kicode01/voltsense-iot/docs/HANDOFF.md

# VoltSense — hardware handoff & build guide

**Who this is for:** whoever has the physical components. You do not need to have seen the code or  
this project before. Follow it top to bottom.

**What you are building:** an ESP32 that senses whether a room is occupied, switches three mains  
sockets, measures the current each one draws, and reports all of it to a phone app. It alerts when  
the room empties or a port overloads.

**What you need from the code owner** (ask them — do not guess):

| Thing | Why |
| --- | --- |
| The **pairing key** (64 hex characters) | Baked into the firmware at build time so the device can register itself. **Sent privately — never put it in a repo or a shared doc.** |
| Confirmation the app is deployed | The device talks to `https://voltsense-iot.vercel.app` |
| A phone with the app installed and signed in | To claim the device at the end |

---

## ⚠️ READ THIS BEFORE TOUCHING ANYTHING

**This device switches mains.** 230 V at up to 5 A per port is lethal and will destroy equipment.

- **Never wire or rewire with the mains connected.** Isolate at the breaker, then verify it is dead.
- **Do the whole bring-up with low-voltage loads first** — 12 V lamps, a phone charger. Only move to  
  mains once Stages 1–4 below pass.
- If you are not confident with mains wiring, stop and get someone who is. Nothing here is worth a  
  shock.
- **Fit the fuses.** One per port, in the live conductor, upstream of the relay — specs in §1.1.  
  The software's overcurrent cutoff is a convenience, not protection: the sensor saturates at 5 A  
  and a welded relay contact cannot be opened in code. Do not energise mains without them.

---

## 1. What's in the box

| Part | Notes |
| --- | --- |
| ESP32 dev board | 4 MB flash minimum |
| HC-SR501 PIR motion sensor | Occupancy. **Needs 5 V.** |
| 3-channel relay module | Switches the three sockets |
| 3× ACS712 current sensor | One per socket. **5 A variant** (the 20 A and 30 A parts look identical and silently break every reading) |
| **Fuse — one per port** | See §1.1. Not optional. |
| 5 V regulated supply | Enough for the ESP32 + relay coils + sensors |

### 1.1 The fuses — fit them, and fit the right ones

The software has an overcurrent cutoff, but it is **explicitly not a fuse**, and the firmware says so  
in its own source. Two things it physically cannot do:

- **The ACS712 saturates at 5 A.** A dead short drawing 30 A reads as ~5 A. The fault is *invisible*  
  to the software — it can only see the band just below the ceiling.
- **A welded relay contact cannot be opened in code.** Opening the relay is best-effort.

So the software and the fuse cover different failures, deliberately:

```
4.5 A   software cutoff (debounced ~0.5 s)  -> soft/sustained overloads; opens the relay
5.0 A   fuse                                -> hard faults, and anything above what
                                               the saturated sensor can see
```

The software threshold sits just **below** the fuse so it acts first on the recoverable case, and the  
fuse is the backstop for what software cannot reach.

**Specification — check what you have against this:**

| Property | Requirement | Why |
| --- | --- | --- |
| Property | Requirement | Why |
|---|---|---|
| **Rating** | **Sized to the weakest link**, not the sensor. For typical parts — 1.5 mm² (~16 AWG) wire and a 10 A relay module — **5 A** is a sensible, conservative choice. **3 A** is *better* protection if the loads are known small | A fuse protects the **wiring and the relay**. A meter that can read 100 A does **not** justify a 100 A fuse |
| **Voltage** | **250 VAC minimum** | It is switching mains |
| **Type** | **Time-lag / slow-blow (T)**, not fast-blow (F) | Motors and switch-mode supplies draw large inrush; a fast fuse nuisance-trips on a healthy appliance. The firmware debounces overcurrent for exactly the same reason |
| **Construction** | **Ceramic / sand-filled — NOT glass** | At 230 V a glass fuse can arc internally and shatter. Ceramic quenches the arc |
| **Breaking capacity** | Must exceed the prospective short-circuit current at the socket | A fuse that cannot interrupt the fault is decoration |
| **Placement** | In the **live** conductor, **one per port**, **upstream of the relay** | So it protects the relay contacts as well as the wiring |
| **Wire gauge** | Must carry the fuse rating continuously (≈0.75 mm² for 5 A, ≈1.5 mm² for 10 A) | A fuse protects the **wiring** — the wire must not be the weakest link |
| **Size** | 5 × 20 mm is the common size; 6.3 × 32 mm has higher breaking capacity | Either is fine domestically |

So a normal specification reads something like **`T5A 250V 5×20mm ceramic`** — time-lag, 5 amp, 250 VAC, ceramic cartridge.

**The rule that decides the rating:**

> A fuse protects the **WIRING and the relay** — not the sensor, and not the load.

```
fuse rating  <=  min( wire current rating , relay contact rating )
```

**A second, independent reason to stay near 5 A on the shipped firmware:** the ACS712-05B current sensors saturate at 5 A, so the software overcurrent cutoff (default 4.5 A) cannot see a fault above that. Keeping the fuse just above the software threshold preserves the layering. **If the build uses a PZEM-004T instead of ACS712s, that constraint disappears** and the rating is set purely by the wiring and relay — see §1.2.

If what your group has is a different rating or type, **say so before wiring** rather than fitting it  
and hoping. A 10 A glass fuse is not equivalent to a 5 A ceramic time-lag one.

#### Reading the marking — the letter that actually matters

A 5×20 mm fuse carries its whole specification in a short code. Look for **`T5AH250V`**:

| Character | Means | Why it matters here |
|---|---|---|
| **T** | Time-lag (slow-blow). `F` = fast | Tolerates motor/SMPS inrush. `F` nuisance-trips on a healthy appliance |
| **5A** | Rating | See the rating rule above |
| **H** | **High** breaking capacity. `L` = low | **This is the one people miss.** Per IEC 60127-2 a 5×20 mm fuse must interrupt **1500 A** to earn `H`; an `L` part is only tested to **35 A**. At 230 V an `L` fuse can fail to clear the fault, arc, and shatter |
| **250V** | Voltage rating | It is switching mains |

So `T5A 250V ceramic` is *almost* the spec — add the **H**. If the marking only says `T5A 250V` with no
`H`, treat it as `L` and prefer a part that states `H` explicitly.

**Also buy a holder:** a **5×20 mm panel-mount or inline fuse holder rated 250 VAC**. Fuses are
single-use; a holder means replacing a fuse rather than resoldering, and a soldered-in fuse turns the
joint into a hot spot. The holder needs its own voltage rating, not just a current one.

#### Do not use these — each is a common, real mistake

| Don't | Why |
|---|---|
| **Glass fuse** | Almost always `L`. Can arc internally and shatter at 230 V |
| **Automotive blade fuse** | Rated **~32 V DC**. Wrong voltage class — it will not safely interrupt a mains fault, whatever its current rating says |
| **Fast-blow (`F`)** | Nuisance-trips on inrush; healthy loads look like faults |
| **Anything well above the rating** | On the shipped ACS712 firmware it leaves the blind band the saturated sensor cannot see |
| **A fuse with no holder** | No safe replacement, and the solder joint becomes a hot spot |

#### Alternative: a small MCB instead of fuses

A **6 A Type-C miniature circuit breaker** is a legitimate substitute, and arguably nicer for a
project: it is **resettable**, so a trip costs a click rather than a fuse, and you carry no spares.
Type C tolerates inrush better than Type B.

Two things to keep straight if you go this way:

- Between the sensor's 5 A ceiling and the 6 A breaker nothing trips promptly — but software is blind
  above 5 A anyway, so nothing is lost that was ever there. The breaker still protects the **wiring**
  against a sustained overload, which is its actual job.
- **The wiring must then be rated for the breaker, not the old fuse.** A breaker protects the wire, so
  the wire must not be the weakest link.

Optional, only if the code owner says so: an AC voltage sensor (ZMPT101B) for real-power metering.  
**Do not fit it unless asked** — it needs calibration and can damage the ESP32 if wired wrong. See  
`docs/VOLTAGE-SENSING.md`.

---

### 1.2 This build is ACS712 + ZMPT101B — do not substitute

The architecture is fixed and the firmware is written around it:

| Part | Role | Quantity |
|---|---|---|
| **ACS712** (5 A variant) | Current sensing, one per port, on the ESP32's ADC1 pins | **3** |
| **ZMPT101B** | Voltage sensing, on GPIO 33 — optional, enables real power (W) instead of VA | **1** |

**Do not swap either part, and do not add a combined energy-meter module.** The firmware reads three
analogue current channels and one analogue voltage channel; anything else is a new integration, not a
drop-in replacement.

In particular: **do not connect a UART energy-meter module (e.g. a PZEM-004T) to GPIO 33.** That pin
is an analogue input — a serial device wired to it will not work and may be damaged.

Alternatives that were considered, and why they were not chosen, are recorded in
`docs/VOLTAGE-SENSING.md` §7. That is design history for the report, **not** wiring instructions.

## 2. Wiring

### Pins — these are fixed by the firmware

| Function | ESP32 pin | Goes to |
| --- | --- | --- |
| Relay 1 / 2 / 3 | **23, 21, 19** | Relay module IN1 / IN2 / IN3 |
| Current sensor 1 / 2 / 3  | **34, 35, 32** | ACS712 OUT, one per port |
| PIR | **22** | HC-SR501 OUT |
| Relay module VCC | 5 V | 5 V rail |
| Relay module GND | GND | **Common ground** |
| mmWave radar *(optional)* | 4 | Only if fitted **and** enabled in firmware |

> **GPIO 34, 35, 32 are input-only and have no pull-ups.** That is correct for analogue inputs and  
> required here — the ESP32's other analogue pins (ADC2) stop working when Wi-Fi is on, so the  
> current sensors must be on ADC1 (GPIO 32–39).

### ⚠️ The four wiring mistakes that will cost you a day

**1. The ACS712 goes IN SERIES with ONE conductor — never both.**  
Cut **one** wire (the live), and pass only that one through the sensor. If live and neutral both go  
through, their magnetic fields cancel and the sensor reads **0 A** while the load is running  
perfectly. It looks like a dead sensor; it is a wiring error.

```
   mains live ──[ through the ACS712 hole ]── to the load
   mains neutral ──────────── straight through, NOT through the sensor
```

**2. Common ground is mandatory.** The ESP32, the relay module, the PIR and every ACS712 must share  
GND. Without it the sensor outputs float and read noise.

**3. Fuse placement.** One fuse per port, in the **live** conductor, **before** the relay:

```
   mains live ──[ FUSE ]──[ relay contact ]──[ ACS712 ]── to the load
   mains neutral ────────────────────────────────────── to the load
```

The ACS712 sits after the relay so it measures what that port is actually drawing. Put the fuse  
upstream so it protects the relay contacts too — a relay alone is not a protective device.

**4. The PIR needs 5 V, and its Tx pot must be SHORT.**  
The HC-SR501 will not work reliably at 3.3 V. It has two potentiometers:

- **Tx (time delay)** — how long OUT stays HIGH after motion. Set it **short** (a few seconds). If it  
  is longer than the firmware's inactivity window (15 min default), the room never registers as  
  empty and the automatic shutdown never fires.
- **Sx (sensitivity)** — leave mid-range to start.

Also set the jumper to **"H" (repeat trigger)**, not "L".

### ✅ Relay polarity — CONFIRMED ACTIVE-LOW

The fitted relay modules are **active-LOW**: pulling a pin **LOW energises the coil**. The firmware
now records this in exactly one place (`RELAY_ON_LEVEL` / `RELAY_OFF_LEVEL` near `RELAY_PINS`) and
every read and write goes through `relayIsOn()` / `relayWritePin()`.

This mattered more than it looks. The firmware previously assumed HIGH = energised in **ten separate
places**, including both protection paths — and those *remove* power by opening the relay. An
inverted level would therefore have **energised a port on an overcurrent fault instead of cutting
it**, and made `relay_status` lie to the app in both directions. It is no longer a "verify on the
bench" item; it is answered, and the harness fails if the levels are changed or bypassed.

One boot detail worth knowing: `pinMode()` leaves the output latch **low**, which on an active-LOW
board means *energised*. The pins are therefore driven to the OFF level *before* being made outputs,
so a reboot never briefly closes every port.

If you ever fit **active-HIGH** modules instead, flip the two constants — nothing else.

---

## 3. Software setup

### 3.1 Arduino IDE

1. Install the Arduino IDE.
2. **File → Preferences → Additional Board Manager URLs**, add:
   ```
   https://espressif.github.io/arduino-esp32/package_esp32_index.json
   ```
3. **Tools → Board → Boards Manager**, search `esp32`, install **esp32 by Espressif**.
4. **Tools → Board → ESP32 Arduino → ESP32 Dev Module**.

### 3.2 Libraries (Tools → Manage Libraries)

| Search for | Notes |
| --- | --- |
| **Firebase Arduino Client Library for ESP8266 and ESP32** | by mobizt. **Not** `FirebaseArduino` or `FireBase32` |
| **WiFiManager** | by tzapu |
| **NTPClient** | by Fabrice Weinberg |

Everything else (`WiFi`, `HTTPClient`, `Preferences`, …) ships with the ESP32 core — do not install  
separately.

### 3.3 ⚠️ Set the partition scheme — the build fails without this

**Tools → Partition Scheme → "Huge APP (3MB No OTA/1MB SPIFFS)"**

The sketch needs ~1.48 MB. The default partition gives only 1.2 MB, so a stock build stops with:

```
Sketch uses 1482683 bytes (113%) of program storage space.
Error during build: text section exceeds available space in board
```

### 3.4 Add the pairing key — do NOT type it into the source file

The key is a **credential**. It must not be saved into `VoltSense.ino`, or it ends up in version  
control and has to be rotated again.

**In the Arduino IDE**, the simplest route is a build flag. Create a file next to the sketch, or use  
**Sketch → Export compiled binary** with an extra flag:

```
-DVOLTSENSE_PAIRING_KEY="<the 64-character key>"
```

**Command line** (equivalent, and easier to script):

```bash
arduino-cli compile \
  --fqbn "esp32:esp32:esp32:PartitionScheme=huge_app" \
  --build-property 'compiler.cpp.extra_flags=-DVOLTSENSE_PAIRING_KEY=\"<the key>\"' \
  esp32/VoltSense
```

> If you forget the key the device still boots, prints  
> `No factory pairing key compiled in; USB provisioning required.` and will not pair over the air.  
> That is a clear failure, not a silent one — but you will have to reflash.

**Easiest route for the Arduino IDE (2.x):** create `esp32/VoltSense/secrets.h` (gitignored) with one
line — `#define VOLTSENSE_PAIRING_KEY "<the key>"`. The sketch picks it up via `__has_include`, so no
build flag is needed. For the command line, `npm run flash:firmware [-- COM5]` reads the key from
`.env` and injects it automatically.

---

## 4. Flash and first boot

1. Connect the ESP32 over USB. If the upload hangs at `Connecting....`, **hold the BOOT button**.
2. Open **Serial Monitor at 115200**.
3. Upload `esp32/VoltSense/VoltSense.ino`.

### What a good boot looks like

```
Connected to WiFi!
Device MAC Address: XX:XX:XX:XX:XX:XX
--- Endpoint reachability self-test ---
  [ OK ] alert ...
  [ OK ] pair  ...
---------------------------------------
   PAIRED. Enter this code in the VoltSense app to add it:
        >>>   XXXXXXXX   <<<
```

**Write down the MAC address** — the code owner needs it, and it is what the server keys everything  
on. Note it is the **Wi-Fi** MAC (`WiFi.macAddress()`), which may differ from the sticker on the  
board.

### If the self-test does not say `[ OK ]`

| Output | Meaning | Do |
| --- | --- | --- |
| `[TLS ]` | The pinned certificate no longer matches | Report it — the firmware needs a certificate update, it is **not** a Wi-Fi problem |
| `[FAIL] WiFi down` | No network | Check Wi-Fi credentials / signal |
| `[FAIL] ... connection refused` | Host unreachable | Check DNS and that the app is deployed |

The probe is a reachability check only — it never carries the alert secret, so a `401` from it is a  
**pass**.

---

## 5. Verification — do these in order

Tick them off. Each one rules out a layer before you add the next.

### Stage 1 — bench, no mains

- [ ] Boots without a reset loop
- [ ] Wi-Fi connects
- [ ] Both endpoints report `[ OK ]`
- [ ] MAC address recorded and sent to the code owner

### Stage 2 — sensors

- [ ] Motion in front of the PIR is detected
- [ ] It goes idle again after you stand still (allow the inactivity window)
- [x] Relay polarity confirmed **active-LOW** (see §2) — recorded in `RELAY_ON_LEVEL`/`RELAY_OFF_LEVEL`
- [ ] Each relay clicks when toggled, and the **right** relay clicks

### Stage 3 — current sensing, still no mains

Use a low-voltage load or a lamp on a bench supply.

- [ ] The loaded port reads a non-zero current
- [ ] Unloaded ports read ~0 A
- [ ] The reading roughly matches a clamp meter

### Stage 4 — relays under load

- [ ] App ON → the outlet is genuinely live
- [ ] App OFF → the outlet is genuinely dead
- [ ] Rapid toggling produces `SUPPRESSED (derating)` in the log and the relay does **not** chatter  
  (this is the protection working, not a fault)

### Stage 4b — load behaviour (do this with the intended loads)

The device is meant for **small appliances: phone and laptop chargers, fans, lamps.** Test with those,
not just with a dummy load.

> ⚠️ **Known issue — expect the shutdown to behave backwards.** The selective shutdown keeps a port
> on if it is drawing current above ~23 W (0.10 A). That rule infers *intent* from *current*, which
> is wrong for these loads:
>
> - **A lamp or large fan left on in an empty room will be KEPT ON** — it draws above the threshold.
>   That is the waste the device exists to remove.
> - **A phone charging on a small brick may be CUT** — it draws below the threshold.
>
> **This is a known defect, not your wiring.** Full analysis in `docs/LOAD-POLICY.md`; the fix
> (a per-port policy) is proposed but not implemented. Do not chase it during bring-up.

Checks, so the behaviour is on record:

- [ ] Lamp on a port → room empties → **note whether the port is cut or kept** (it will likely be kept)
- [ ] Phone charger on a port → room empties → **note whether it is cut** (it may be cut mid-charge)
- [ ] Report both to the code owner — they are the evidence for the fix

### Stage 5 — safety cutoffs

- [ ] **Fuses fitted and correct**: 5 A max, 250 VAC, ceramic, time-lag, one per port, in the live  
  conductor upstream of the relay — confirmed against §1.1 **before** energising mains
- [ ] **The software trips first**: raise the load past 4.5 A but below the fuse rating → the relay  
  opens and the log shows `OVERCURRENT TRIP`. This proves the layering works — if the fuse blows  
  instead, the software threshold is not doing its job
- [ ] Overcurrent: exceed the limit (default 4.5 A) → relay opens, log shows `OVERCURRENT TRIP`
- [ ] Occupancy: let the room go idle → an alert arrives, and pressing **Keep Power On** in the app  
  cancels the shutdown
- [ ] The device survives a full idle → shutdown cycle without resetting

### Stage 6 — pairing and the app

- [ ] The pairing code from the serial log is accepted by the app
- [ ] The dashboard shows live readings, not "Demo"
- [ ] Unpairing from the app removes it from the account

### Stage 7 — real push notification

- [ ] With the app **fully closed** (swiped away, not just backgrounded), trigger an alert and  
  confirm the phone shows a notification. `docs/PUSH-TEST.md`.

> The **Settings → Test** button does **not** test this. It fires a notification from the open page  
> and passes even on a broken build. Only a real alert with the app closed proves delivery.

---

## 6. What to report back

Send the code owner:

1. **The MAC address** from the serial log.
2. **The pairing code**, or confirmation the device was claimed.
3. **The relay polarity — settled: active-LOW**, and it must be re-checked if the modules are ever
   swapped for a different board.
4. **The current reading vs a clamp meter**, so the sensor variant can be confirmed.
5. **Any serial log that did not match the expected output** — paste it verbatim, it is the fastest  
   way to diagnose.
6. Which stages in §5 passed, and where you stopped.

---

## 7. Troubleshooting quick reference

| Symptom | Most likely cause |
| --- | --- |
| Upload hangs at `Connecting....` | Hold the BOOT button during upload |
| `text section exceeds available space` | Partition scheme not set to Huge APP |
| Device boots but never pairs | Pairing key not supplied at build time |
| A port reads 0 A under load | ACS712 not in series with a single conductor, or no common ground |
| Occupancy never clears | PIR Tx pot too long, or a floating mmWave pin |
| Ports are inverted (ON = dead) | Active-low relay module — see §2 |
| Nothing arrives on the phone | App must be closed for the real test; check `docs/PUSH-TEST.md` |
| `Alert -> HTTP 401` | The device's alert secret does not match the server — report it |
