kicode01/voltsense-iot/docs/screenshots/enclosure_3d_digital_twin.png

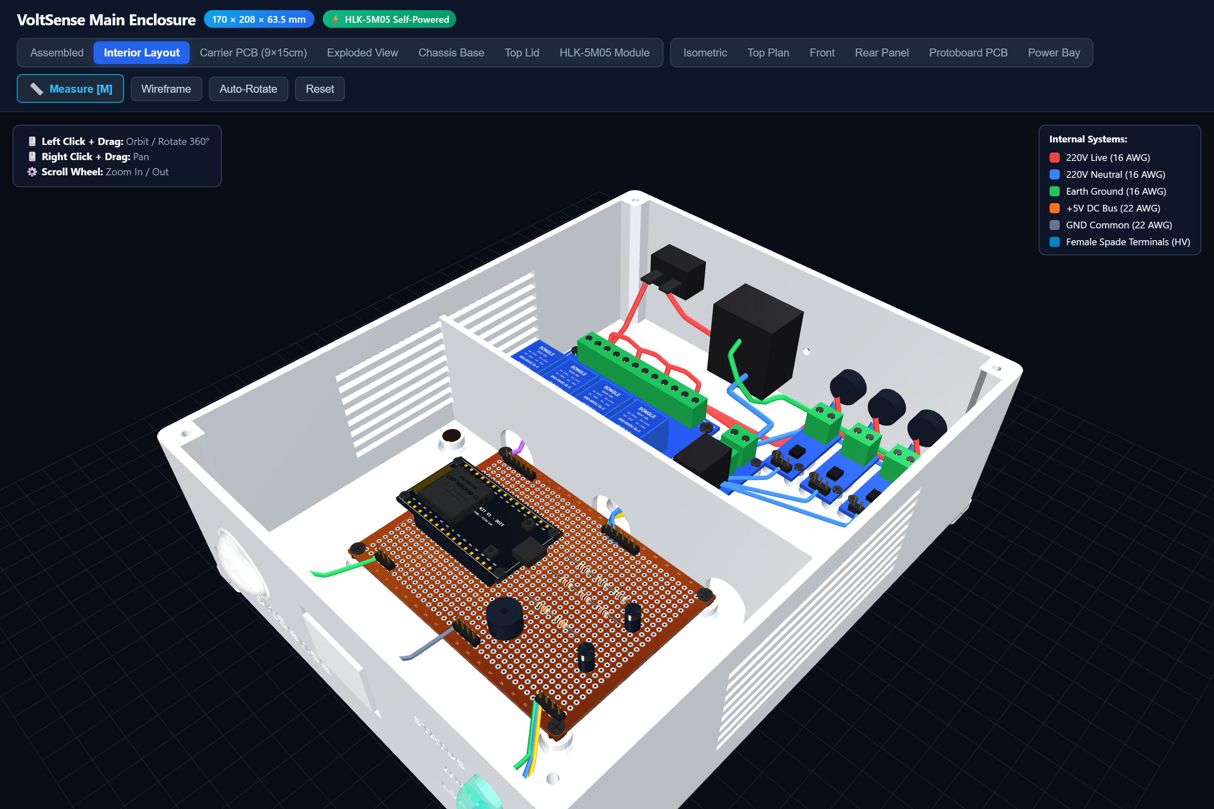
docs/screenshots/enclosure_3d_digital_twin.png
