kicode01/voltsense-iot/public/assets/voltsense_wifi_qr.png

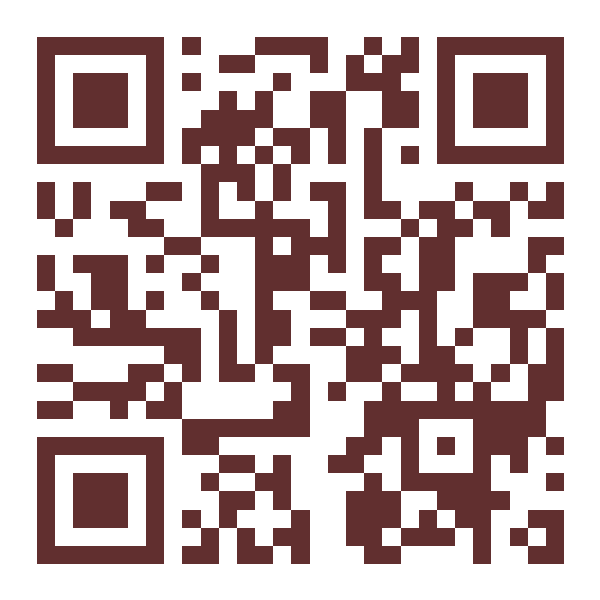
public/assets/voltsense_wifi_qr.png
