kicode01/voltsense-iot/public/cad/student_face_crop_preview.png

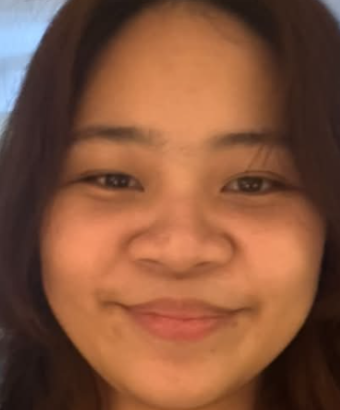
public/cad/student_face_crop_preview.png
