kicode01/voltsense-iot/public/cad/student_face_sleep_uv.png

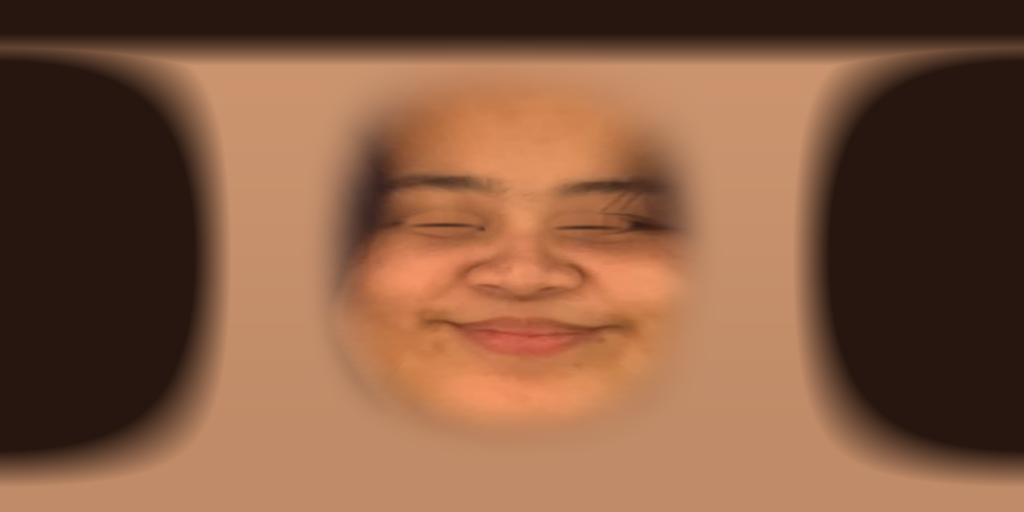
public/cad/student_face_sleep_uv.png
