kicode01/voltsense-iot/public/cad/universal_pcb_texture.png

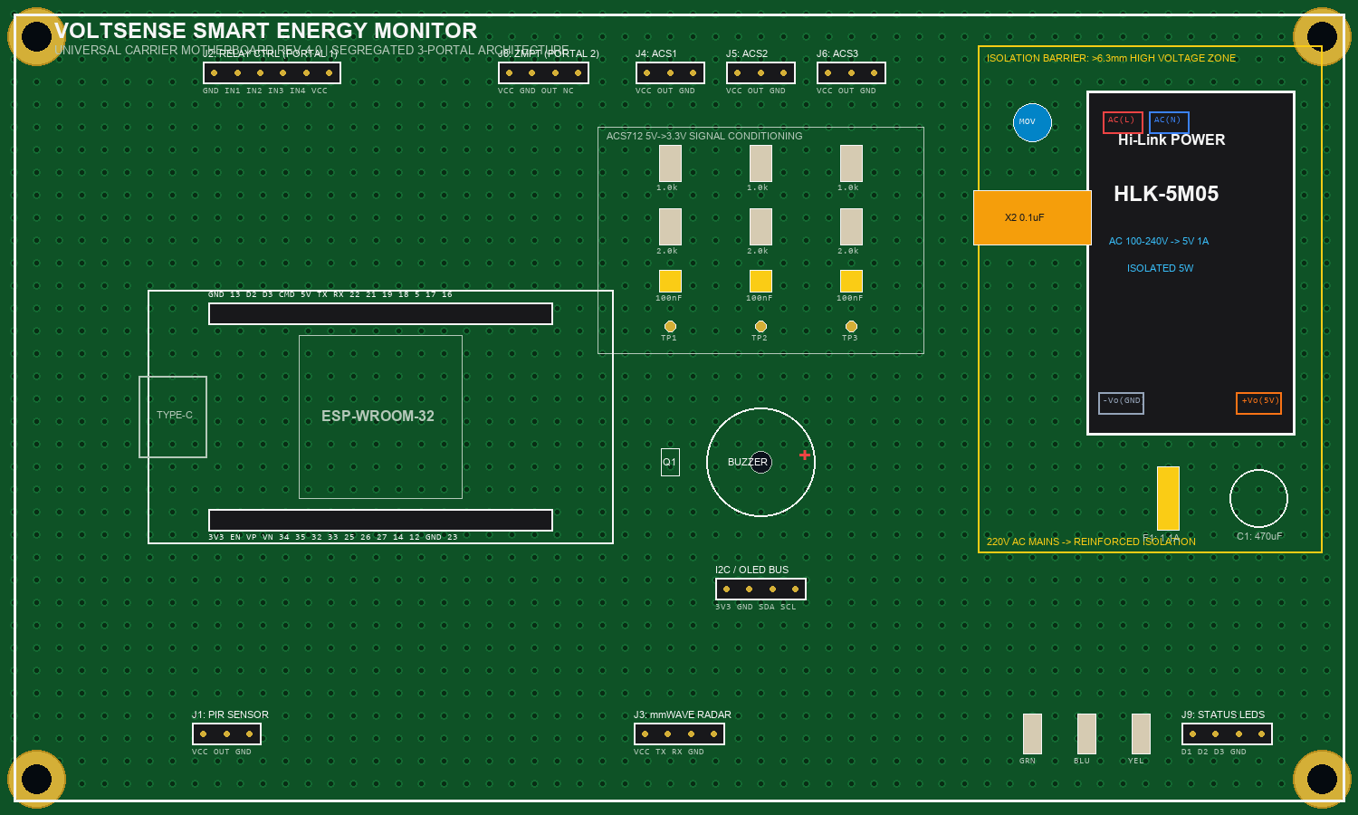
public/cad/universal_pcb_texture.png
