kicode01/voltsense-iot/public/pwa-192x192.png

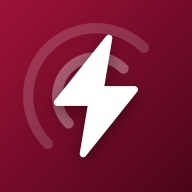
public/pwa-192x192.png
