kicode01/voltsense-iot/cad/voltsense_enclosure_assembled.stl

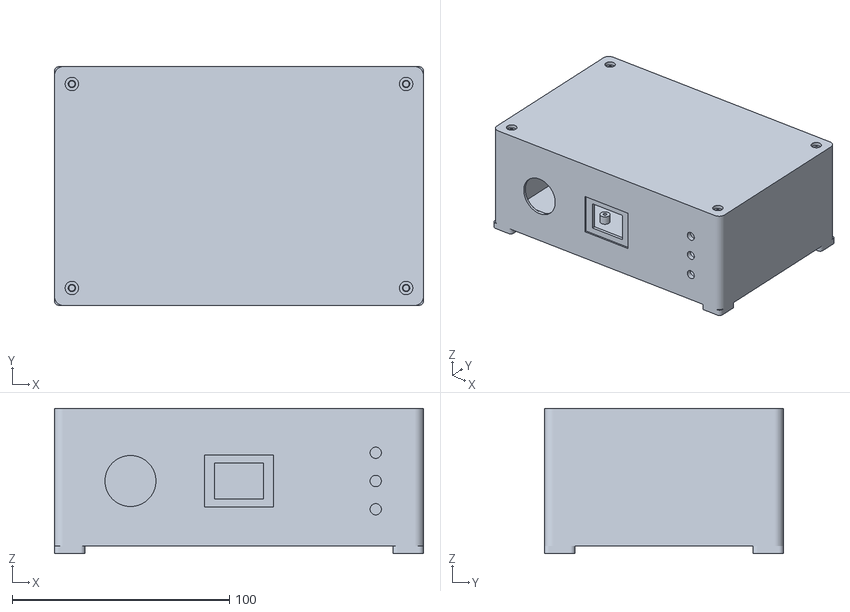
[picture p13: CAD file, 2026-10-14]
cad/voltsense_enclosure_assembled.stl
170.0 x 110.0 x 67.0
