kicode01/voltsense-iot/public/cad/voltsense_hlk_5m05.stl

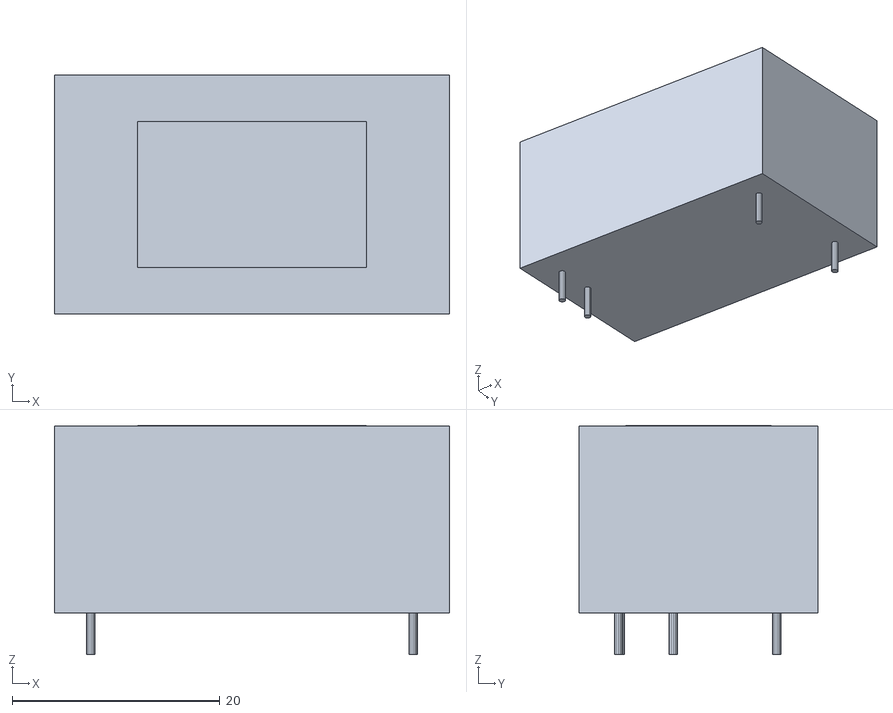
[picture p14: CAD file, 2026-10-27]
public/cad/voltsense_hlk_5m05.stl
38.0 x 23.0 x 22.1
