kicode01/voltsense-iot/cad/voltsense_enclosure_base_final.stl

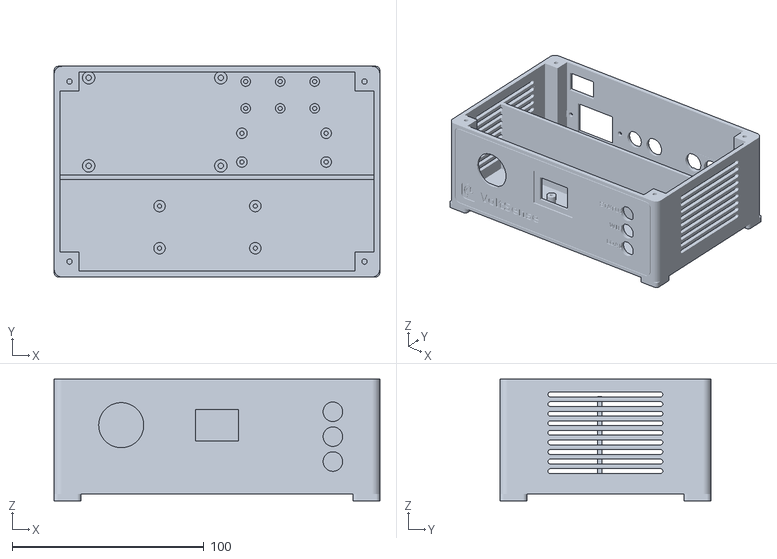
[picture p15: CAD file, 2026-10-15]
cad/voltsense_enclosure_base_final.stl
170.2 x 110.1 x 63.5
