kicode01/voltsense-iot/public/cad/voltsense_enclosure_base_final.stl

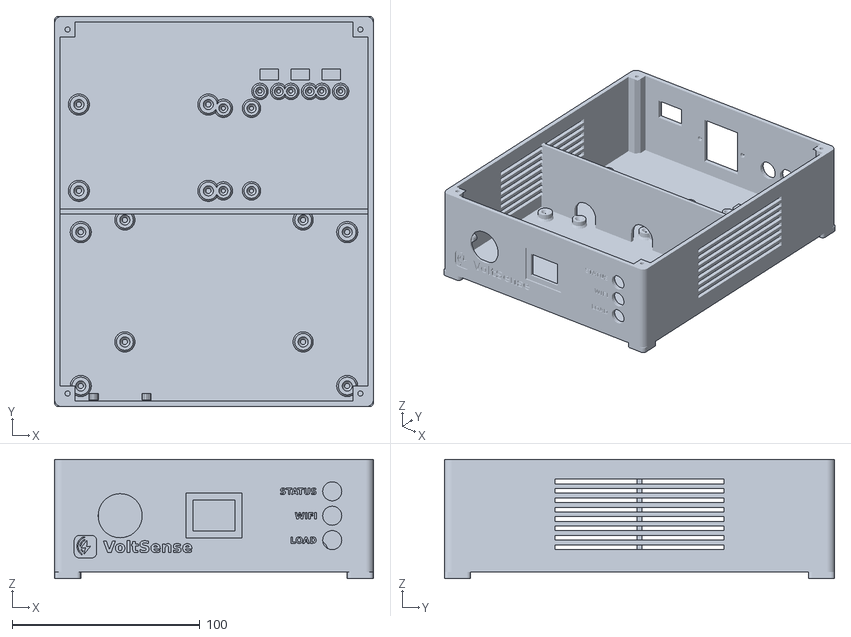
[picture p16: CAD file, 2026-10-27]
public/cad/voltsense_enclosure_base_final.stl
170.0 x 208.0 x 63.5
