kicode01/voltsense-iot/cad/voltsense_enclosure_lid_final.stl

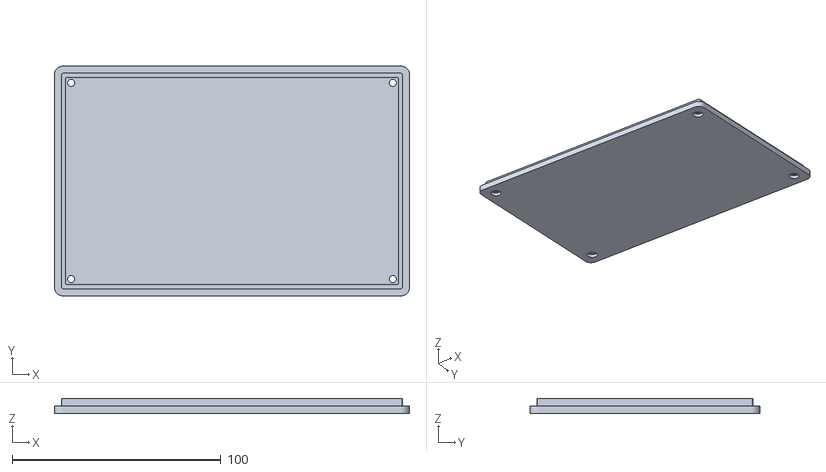
[picture p17: CAD file, 2026-10-15]
cad/voltsense_enclosure_lid_final.stl
170.0 x 110.0 x 7.00
