kicode01/voltsense-iot/public/cad/voltsense_ss6b_socket.stl

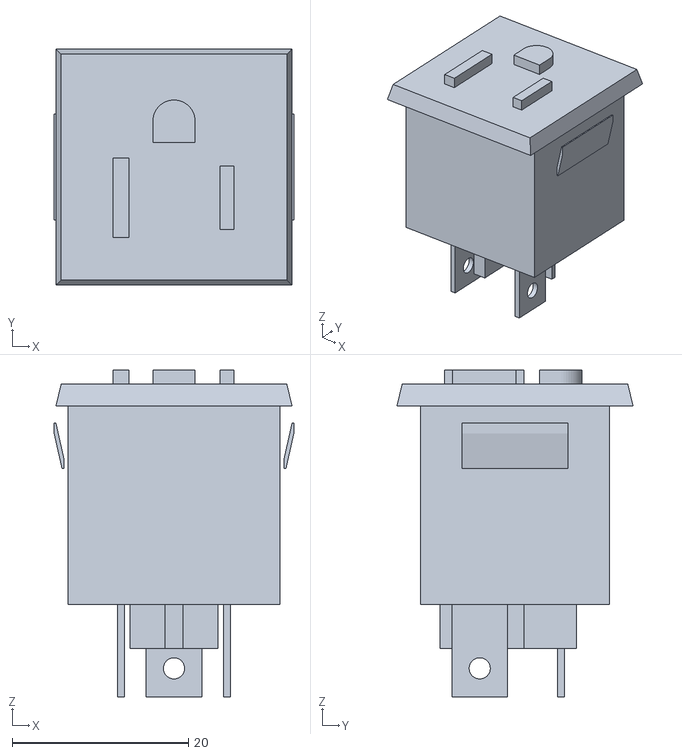
[picture p18: CAD file, 2026-10-27]
public/cad/voltsense_ss6b_socket.stl
27.2 x 26.8 x 37.1
