kicode01/voltsense-iot/public/cad/voltsense_enclosure_final.stl

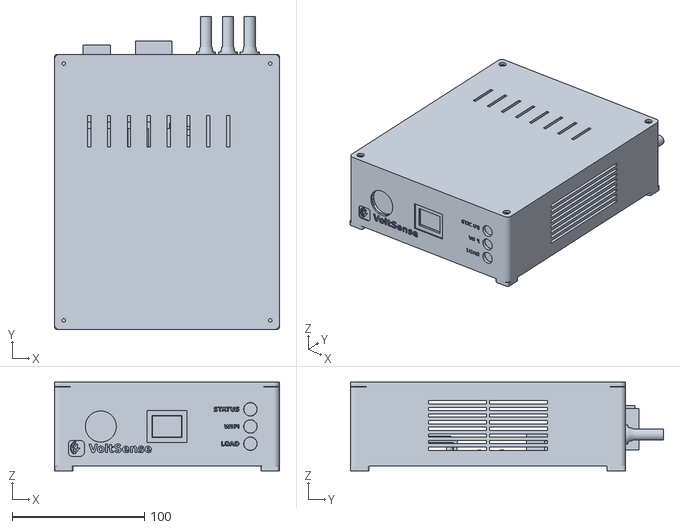
[picture p19: CAD file, 2026-10-27]
public/cad/voltsense_enclosure_final.stl
170.0 x 236.6 x 67.0
