kicode01/voltsense-iot/public/cad/voltsense_port_1_pod.stl

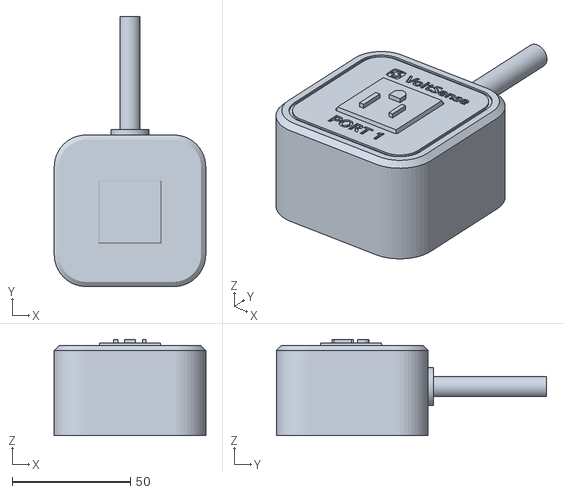
[picture p20: CAD file, 2026-10-27]
public/cad/voltsense_port_1_pod.stl
64.0 x 114.0 x 40.7
