kicode01/voltsense-iot/public/cad/voltsense_port_pod_case_p1.stl

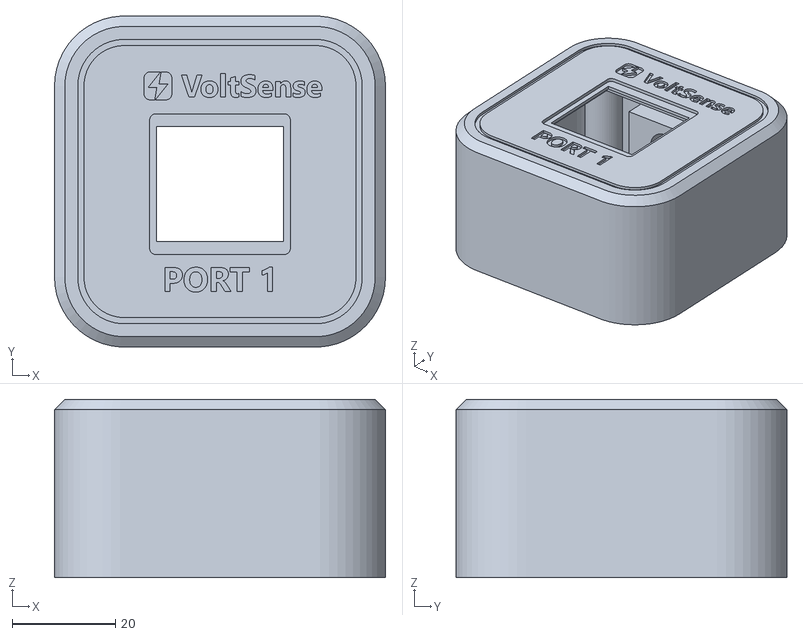
[picture p21: CAD file, 2026-10-27]
public/cad/voltsense_port_pod_case_p1.stl
64.0 x 64.0 x 34.5
