kicode01/voltsense-iot/public/cad/voltsense_internal_components.stl

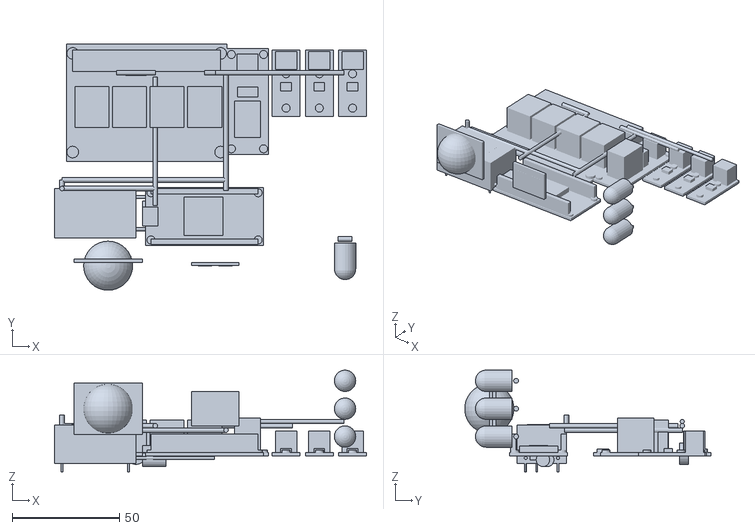
[picture p22: CAD file, 2026-10-27]
public/cad/voltsense_internal_components.stl
145.5 x 114.9 x 47.5
