kicode01/voltsense-iot/public/cad/voltsense_port_pod_lid.stl

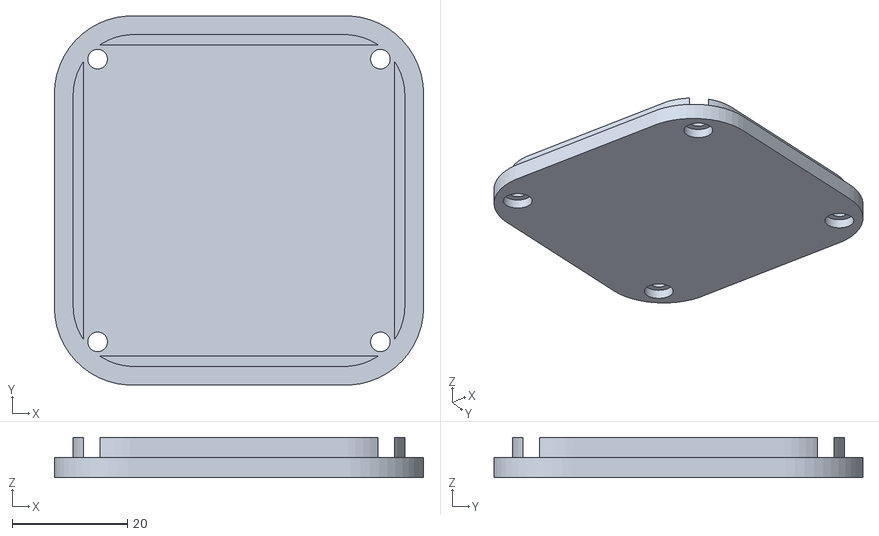
[picture p23: CAD file, 2026-10-27]
public/cad/voltsense_port_pod_lid.stl
64.0 x 63.9 x 7.00
