kicode01/voltsense-iot/public/cad/voltsense_enclosure_lid_final.stl

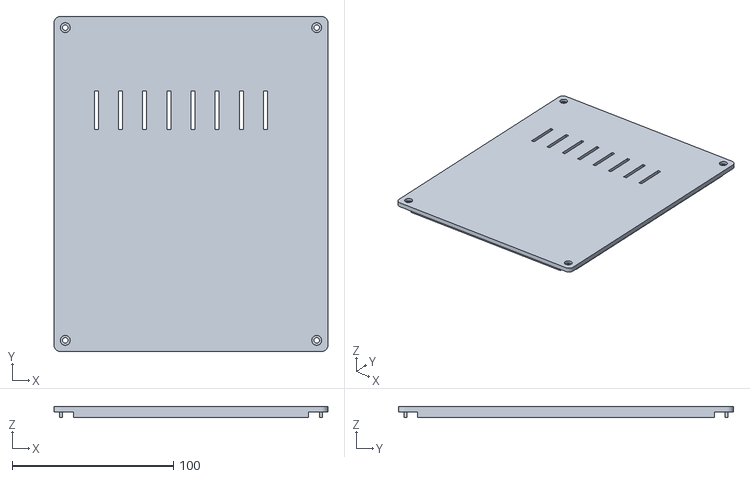
[picture p24: CAD file, 2026-10-27]
public/cad/voltsense_enclosure_lid_final.stl
170.0 x 208.0 x 7.00
