kicode01/voltsense-iot/public/cad/voltsense_enclosure_interior.stl

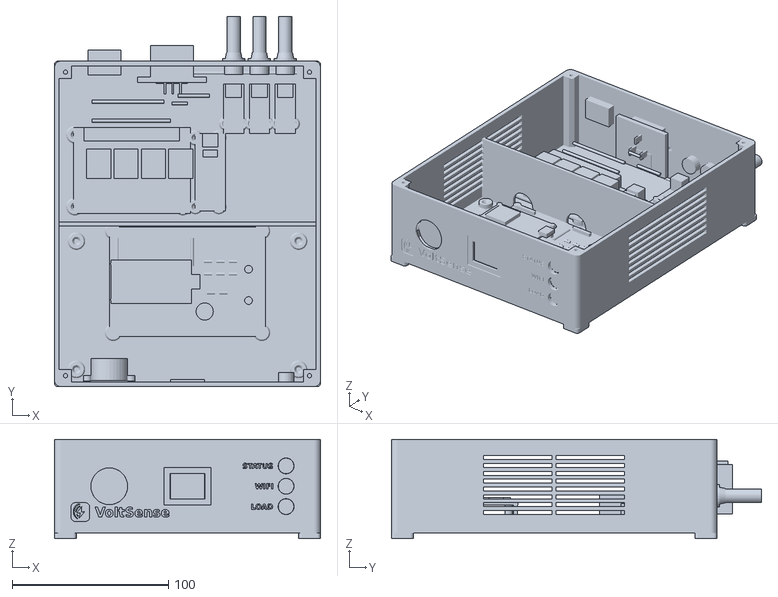
[picture p25: CAD file, 2026-10-27]
public/cad/voltsense_enclosure_interior.stl
170.0 x 236.6 x 63.5
