kicode01/voltsense-iot/(list of files, cad)

Other CAD files:
cad/voltsense_enclosure_final.stl
cad/voltsense_enclosure_base.stl
public/cad/voltsense_port_3_pod.stl
public/cad/voltsense_port_2_pod.stl
public/cad/voltsense_port_pod_case_p3.stl
public/cad/voltsense_port_pod_case_p2.stl
