kicode01/voltsense-iot/public/cad/diagrams/hardware_wiring_visual.jpg

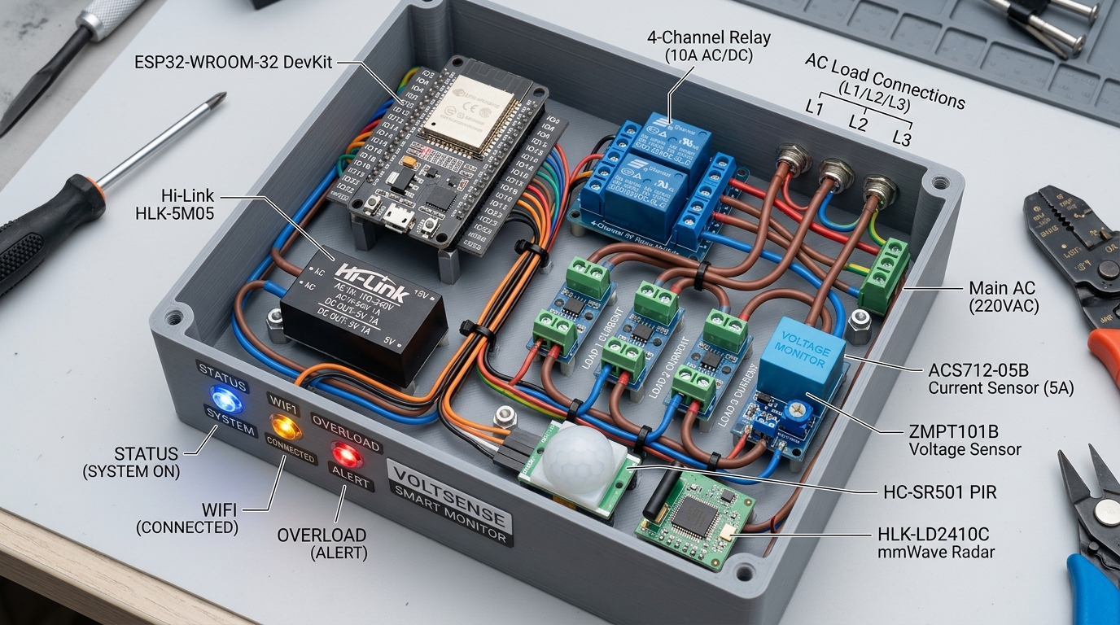
public/cad/diagrams/hardware_wiring_visual.jpg
