kicode01/voltsense-iot/public/cad/kicad/VoltSense.kicad_sch

## KiCad design public/cad/kicad/VoltSense.kicad_sch (2026-10-27)

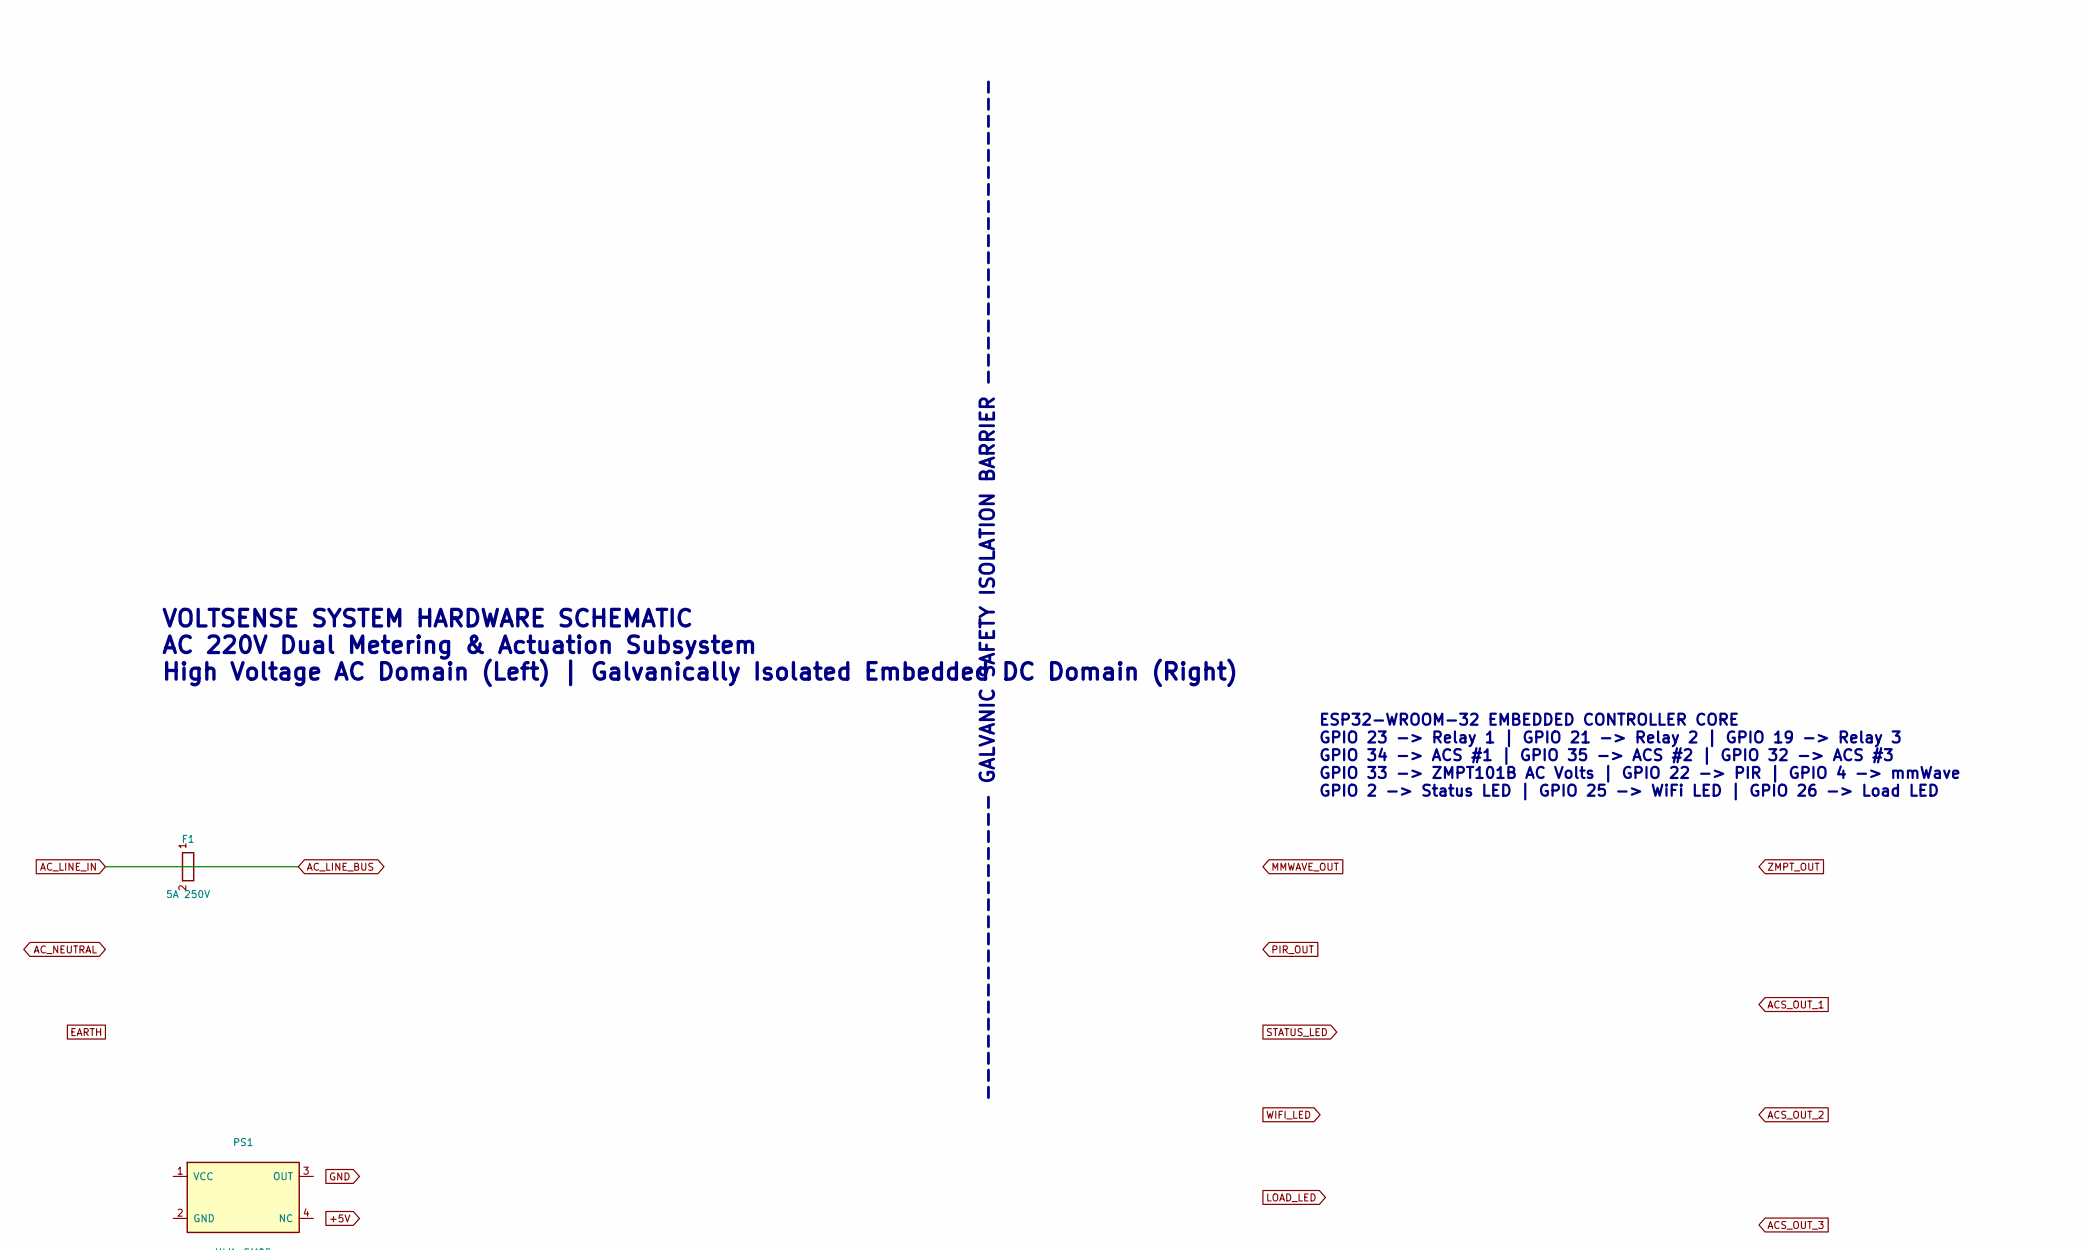
[picture p27: schematic VoltSense.kicad_sch, part in row 1, column 1]

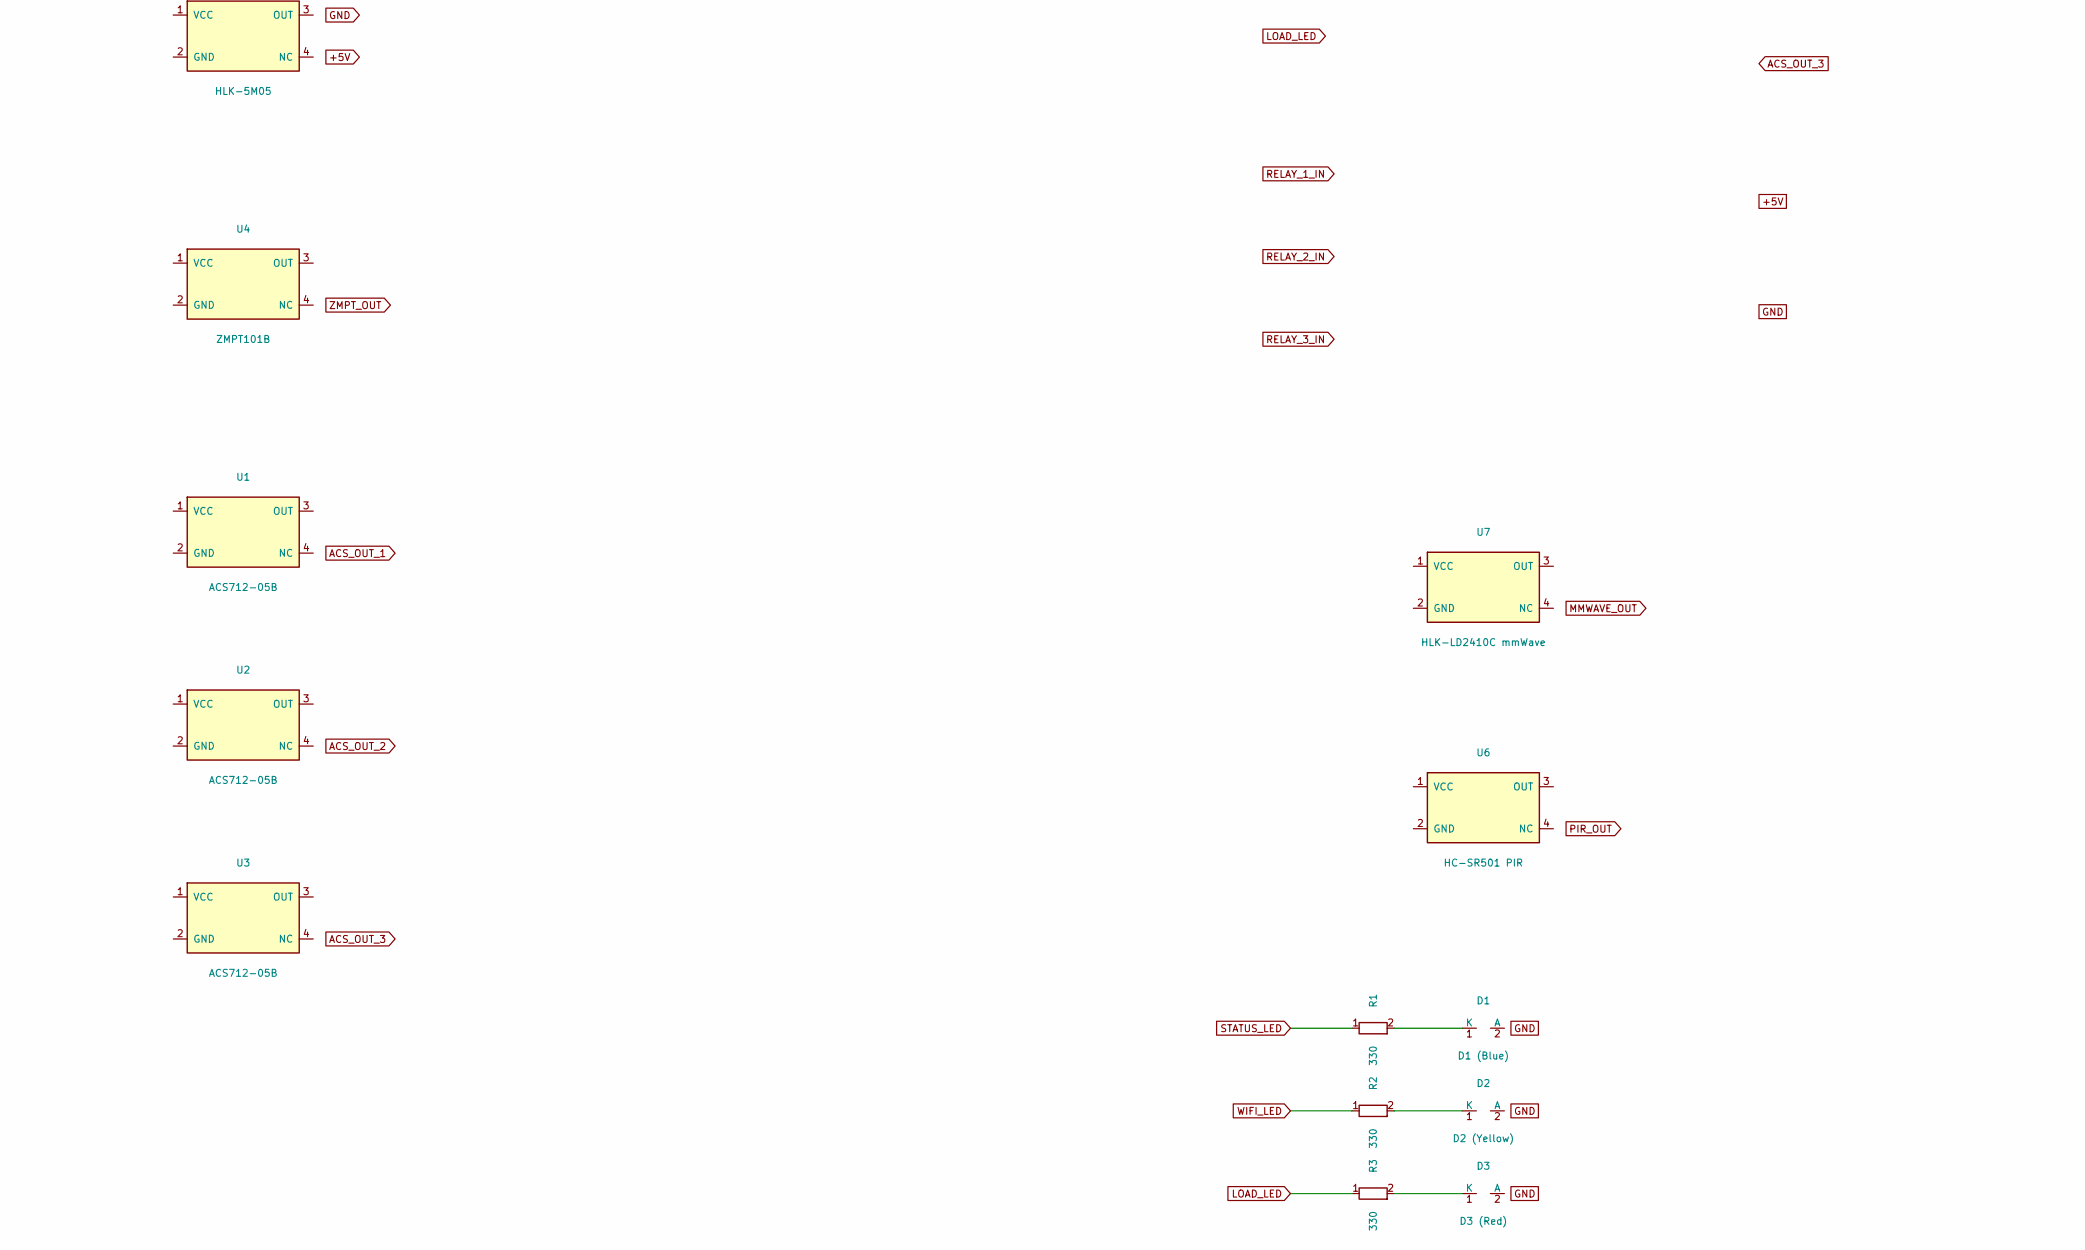
[picture p28: schematic VoltSense.kicad_sch, part in row 2, column 1]

Parts:
D1: D1 (Blue)
D2: D2 (Yellow)
D3: D3 (Red)
F1: 5A 250V
PS1: HLK-5M05
R1, R2, R3: 330
U1, U2, U3: ACS712-05B
U4: ZMPT101B
U6: HC-SR501 PIR
U7: HLK-LD2410C mmWave

Connections:
LOAD_LED: R3.1
unnamed: D1.1 (K), R1.2
unnamed: D2.1 (K), R2.2
unnamed: D3.1 (K), R3.2
STATUS_LED: R1.1
WIFI_LED: R2.1

Notes on the sheet:
VOLTSENSE SYSTEM HARDWARE SCHEMATIC AC 220V Dual Metering & Actuation Subsystem High Voltage AC Domain (Left) | Galvanically Isolated Embedded DC Domain (Right)
------------------ GALVANIC SAFETY ISOLATION BARRIER ------------------
ESP32-WROOM-32 EMBEDDED CONTROLLER CORE GPIO 23 -> Relay 1 | GPIO 21 -> Relay 2 | GPIO 19 -> Relay 3 GPIO 34 -> ACS #1 | GPIO 35 -> ACS #2 | GPIO 32 -> ACS #3 GPIO 33 -> ZMPT101B AC Volts | GPIO 22 -> PIR | GPIO 4 -> mmWave GPIO 2 -> Status LED | GPIO 25 -> WiFi LED | GPIO 26 -> Load LED
