kicode01/voltsense-iot/(commit log)

2026-10-08 Initial commit: VoltSense ESP32 occupancy-driven power monitoring
    ESP32 firmware + React PWA + Vercel serverless API.
    - Firmware: PIR occupancy, per-port ACS712 current sensing (ADC1), 3-channel
    relay control with dwell/rate derating, task watchdog, soft overcurrent
    cutoff, self-pairing over the air.
    - App: Dashboard, Analytics, Alerts, Settings; PWA with background push (FCM
    shares the Workbox service worker).
    - API: /api/pair, /api/claim, /api/unpair, /api/alert on Vercel.
    - Gate: npm run verify (lint, typecheck, 50 unit, build, 123 harness checks).
2026-10-08 ci: supply the VITE_* build config from repository secrets
    CI failed on the first run with a single assertion:
    FAIL VAPID key present in bundle (from .env) — MISSING
    The build inlines the VITE_* web config, but those values live in .env, which is
    correctly gitignored — so the CI checkout had none of them. The build still
    SUCCEEDED and simply produced a bundle without them, which is why the failure
    showed up ~90s later as a harness assertion rather than at the build step.
    - Pass the 8 VITE_FIREBASE_* secrets to the Build step.
    - Add a 'Verify build configuration' guard that fails with an explicit list of
    missing secrets, so this can never again present as a confusing code failure.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
2026-10-08 feat(firmware): real-power voltage sensing; make the firmware compile
    VOLTAGE SENSING (gated, ships off)
    Adds HAS_VOLTAGE_SENSE: an optional ADC1 voltage channel (GPIO 33) that turns
    the power figures from an estimate into a measurement.
    - readPowerPort() accumulates sumV2 / sumI2 / sumVI and computes real power as
    mean(v*i) -- the sample-by-sample product. V_rms * I_rms is still VA; only the
    product captures phase, which is what makes the reading watts.
    - DC bias removed per channel BEFORE multiplying (peak-to-peak never needed this,
    the product does). int64 accumulators: a squared sample is ~1.1e7 and 512 of
    them overflow int32.
    - Power factor derived (W/VA) and bounded; calibrati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
2026-10-08 security: remove the committed factory pairing key
    VOLTSENSE_PAIRING_KEY was hard-coded with its real 64-hex value and pushed to
    this PUBLIC repository in the initial commit. It matches .env, so it is the
    live key, not a placeholder.
    It is a genuine credential, not a public-ish identifier. /api/pair accepts it,
    and a caller holding it plus a MAC receives that device's device_password and
    alert_secret. Those authenticate as the device, and the rules grant a device
    full write to its own node -- including ports/<id>/relay_status, i.e. the
    physical relays. The per-device rate limit (1/min, 10/h) does not stop a
    targeted attempt.
    - Replace the literal with an empty default. The existing #ifndef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
2026-10-08 docs: hardware handoff packet for the groupmate
    The components are with a distant groupmate; the code owner needs a document
    they can hand over. docs/HANDOFF.md is self-contained for someone who has never
    seen the project: BOM, mains safety first, exact pin table, the wiring traps,
    IDE/library/partition setup, how to inject the pairing key at BUILD time (never
    into the source), flashing, expected serial output, a 7-stage verification
    checklist, and what to report back.
    Two hardware traps documented, both silent:
    - RELAY POLARITY. runRelaySwitch() drives HIGH = energised, and the firmware's
    own comment flags that as board-dependent. Most cheap relay modules are
    active-LOW, which inverts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
2026-10-08 docs: specify the fuse — the group has them, the spec matters
    The group has fuses, so the last HIGH safety gap is hardware-covered. But 'fit a
    fuse' is not actionable: a 10 A glass fuse is not equivalent to a 5 A ceramic
    time-lag one, and a fuse above the ACS712's 5 A ceiling leaves exactly the blind
    spot the software cannot cover.
    Documents the layering and why the numbers are what they are:
    4.5 A software cutoff (debounced) -> soft/sustained overloads; opens the relay
    5.0 A fuse -> hard faults, and anything above what the
    saturated sensor can see
    The software threshold sits just BELOW the fuse so it acts first on the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
2026-10-08 docs: identify the voltage sensor BEFORE wiring it — the answer forks
    'AC voltage sensor' covers several different devices and only some can produce
    real power. Added the fork to VOLTAGE-SENSING.md (1.1-1.2) with a pointer from
    HANDOFF.md, because 'fit the voltage sensor' is not actionable.
    ZMPT101B module ............ AC waveform, biased -> W, full path works
    AC-AC adapter .............. scaled AC sine -> W (needs divider + bias)
    Module with a DC output .... DC proportional RMS -> VA ONLY
    PZEM-004T / energy meter ... UART -> W, but a DIFFERENT integration
    Resistive divider .......... scaled AC -> NOT ISOLATED, do not use
    The DC-output typ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
2026-10-08 docs: lock the build to ACS712 + ZMPT101B; specify the fuse part
    DESIGN DECISION: the build is 3x ACS712 (current) + 1x ZMPT101B (voltage). The
    PZEM-004T route is out.
    HANDOFF.md is read by whoever WIRES THE BOARD, so a viable-looking alternative in
    it invites someone to build a different device than the firmware supports.
    Section 1.2 is now a short 'this build is ACS712 + ZMPT101B -- do not substitute'
    statement, with the PZEM reasoning PRESERVED as VOLTAGE-SENSING.md section 7
    'Alternatives considered' (one module per circuit, UART count, ACS712-specific
    overcurrent bounds). The analysis was good; it belonged in the design doc.
    FUSE, specified concretely -- 'which fuse?' answered with T5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
2026-10-08 docs: feature <-> hardware inventory, and the gaps between
    Built by grepping BOTH directions: what each software feature needs from
    hardware, and what software uses each piece of hardware. Then diffing the RTDB
    key sets the firmware reads, the firmware publishes, and the app uses. An inert
    write and an ignored output both look like working code, so no existing check
    could see either.
    Four gaps found that were invisible before:
    - ports/<id>/voltage is PUBLISHED BUT NEVER DISPLAYED. The measured mains
    voltage -- the one number the ZMPT101B exists to produce -- has no UI. And
    calibration compares against exactly that number, so the procedure in
    VOLTAGE-SENSING.md cannot be done from the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
2026-10-08 fix: close software-side gaps — per-port policy, console-only settings UI, surfaced telemetry
    - Per-port shutdown policy (occupancy / always_on / keep_while_drawing) replaces the
    inferred rule that kept a lamp on in an empty room while cutting a phone mid-charge.
    - Settings UI for the four console-only limits (inactivity, overcurrent, nominal voltage,
    voltage calibration) written via update() so sibling settings are not wiped.
    - Alert copy derived from RESPONSE_WINDOW_MS (5 min); dashboard countdown falls back to 300.
    - keep_while_drawing re-checks after shutdown (SHUTDOWN_RECHECK_MS) so it releases once
    charging finishes.
    - Dashboard uses real is_occupied, shows night_mode_active, a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
2026-10-09 fix(firmware): idempotent task watchdog; survive the blocking WiFiManager portal
    - esp_task_wdt_add(NULL) returns ESP_ERR_INVALID_STATE (258, 'already subscribed')
    when the core has already enrolled loopTask. That is success, not failure — the task
    IS watched. Treat it as armed instead of printing 'could not watch loopTask'.
    - Reconfigure the TWDT first (only init when it does not exist), which also removes the
    noisy 'TWDT already initialized' error log on every boot.
    - Do NOT hold the 30 s timeout across WiFiManager: its captive portal blocks for minutes
    and cannot feed the timer, which is what tripped the watchdog at ~42 s during setup.
    Widen to 15 min for provisioning, then re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
2026-10-09 feat(firmware): name a DNS failure in the connectivity self-test
    The ESP32 HTTPClient reports a DNS failure and a refused TCP connect with the SAME code
    (-1, 'connection refused'), so 'this network has no internet' is indistinguishable from
    'the server is down'. Resolve the API host explicitly and print the IP — or an explicit
    DNS-FAILED line — before probing the endpoints.
2026-10-09 feat: add `npm run flash:firmware` — inject the pairing key at build time
    The factory key must be supplied via -DVOLTSENSE_PAIRING_KEY at build time (never committed), and a
    build that omits it boots but refuses to pair over the air — an easy mistake with a hand-typed flag.
    This reads VOLTSENSE_PAIRING_KEY from .env / .env.local, injects it, and refuses to build with an
    empty key. Pass a port to also upload:
    npm run flash:firmware # compile only
    npm run flash:firmware -- COM5 # compile + upload
2026-10-09 feat(firmware): allow the pairing key in a gitignored secrets.h (IDE builds)
    Arduino IDE 2.x has no convenient GUI for a -D flag, which is how a keyless build keeps happening.
    The sketch now #includes secrets.h when it sits next to the sketch, so IDE users can put
    VOLTSENSE_PAIRING_KEY there. .gitignore excludes it, so the key never enters version control. CLI
    users keep -DVOLTSENSE_PAIRING_KEY / npm run flash:firmware. Documented in docs/HANDOFF.md 3.4.
2026-10-09 fix(flash:firmware): find arduino-cli off PATH, and use a short build path
    Two problems on a stock Windows box:
    - The official installer puts arduino-cli in 'C:\Program Files\Arduino CLI' WITHOUT adding it to
    PATH, so a bare arduino-cli call fails on a machine where it is plainly installed. The helper now
    falls back to the usual install locations.
    - arduino-cli's default build dir (AppData\Local\arduino\sketches\<32-hex>\) is too deep for the
    Firebase library's nested BearSSL sources, and the build dies with 'opening dependency file ...
    No such file or directory'. A short --build-path fixes it.
    The sketch then compiles at 47% flash / 16% RAM. Verified end to end: npm run flash:firm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
2026-10-09 fix(firmware): correct the watchdog "already subscribed" error code; scan Wi-Fi at boot
    - esp_task_wdt_add(NULL) returns ESP_ERR_INVALID_ARG (0x102 / 258) on ESP-IDF 5.x, NOT
    ESP_ERR_INVALID_STATE. The previous check only matched the latter, so a working watchdog still
    printed "could not watch loopTask: 258" on every boot. Both codes now count as armed.
    - The reconfigure fallback no longer tests one specific code (this family has returned both across
    ESP-IDF versions); any non-OK reconfigure falls back to init.
    - setup() now scans and prints the visible 2.4 GHz networks before WiFiManager runs. When a saved
    SSID stops connecting, this names the cause: out of range vs wrong password v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
2026-10-09 feat(firmware): print network config and a raw TCP test in the connectivity self-test
    When the endpoints report "connection refused" while DNS resolves fine, the cause is the network
    (no gateway / no NAT / captive portal), not the firmware — but the log did not say so. The self-test
    now prints ip / gateway / mask / dns and does ONE raw TCP connect to www.google.com:443, which
    separates "the whole network has no outbound route" from "only our API host is blocked".
2026-10-09 fix(firmware): pin the CA Vercel actually uses — a stale root was killing alerts AND pairing
    The firmware pinned ISRG Root X1 (Let's Encrypt) while Vercel now serves a Google Trust
    Services chain:
    *.vercel.app <- WR1 <- GTS Root R1
    So every TLS handshake was rejected. The cruelty is the reporting: HTTPClient gives a
    certificate failure the SAME code AND string as a refused TCP connect ("connection
    refused"), so this looked like a dead Wi-Fi network for a long time. It was not: the
    device's own network reaches the API host fine over raw TCP.
    Proven locally before touching the board:
    openssl verify -CAfile gtsr1.pem -untrusted WR1.pem leaf.pem -> OK
    openssl verify -CAfil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
2026-10-10 feat(firmware): reach the Realtime Database over REST (proven on hardware)
    The bundled Firebase client library cannot complete a TLS handshake with Google's RTDB frontends
    on ESP32 core 3.x -- it ships its own BearSSL stack and the board reports "Incoming protocol or
    record version is unsupported" -- while the SAME board reaches the SAME host with the core's
    native mbedTLS client. Swapping the library's TLS layer was tried and reverted: its connection
    lifecycle assumes BearSSL's own connected()/available()/stop() semantics.
    So the device now speaks the RTDB REST API directly, over the HTTPClient + API_ROOT_CA_BUNDLE path
    that is proven here. Same database, same rules, no client library: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
2026-10-10 feat(firmware): run the whole data path over the Realtime Database REST API
    Completes the move begun in 2f72c68. The bundled Firebase client library cannot handshake with
    Google's RTDB frontends on ESP32 core 3.x, so every read and write now goes through the REST API
    over the HTTPClient + API_ROOT_CA_BUNDLE path that is proven on this board.
    - Auth: email/password (pairing) and refresh-token (npm run mint-token) sign-in over Identity
    Toolkit / securetoken. Token refreshed at 55 min.
    - Writes: updateNode/setJSON/setBoolAsync/setInt -> PATCH/PUT <path>.json?auth=<idToken>.
    - Commands: the RTDB STREAM is replaced by pollRemoteChanges(), one small GET every 3 s that only
    dispatches when the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
2026-10-10 feat(firmware): read back the room node once, to prove telemetry really lands
    A 2xx from the REST API only proves a request was accepted; it does not prove the values reached the
    database. pollRemoteChanges() now reports what the room node actually holds, once telemetry is
    present, and says so plainly if it never appears:
    RTDB read-back: 1764 bytes, telemetry=yes, diag=yes (poll #1)
    Verified on the board with the network up -- the whole chain works end to end:
    [ OK ] alert reachable (HTTP 405) [ OK ] pair reachable (HTTP 405)
    Authenticated!
    [ OK ] signed in, idToken obtained
    [ OK ] wrote /devices/58:2A:BD:D4:8F:98/diag
    [ OK ] read back: {"rest_ok":12552}
    RT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
2026-10-10 refactor(firmware): remove what the REST move left dead, and fix what it left lying
    Cleanup after the data path moved to the RTDB REST API. Nothing here changes behaviour except the
    error messages, which were actively misleading.
    - `FirebaseData fbdo` was still referenced by four failure messages as `fbdo.errorReason()`, which
    nothing populates any more -- so every one of them printed an empty reason. They now name the
    operation; `rtdbRequest()` already prints the HTTP code and path.
    - `FirebaseAuth` / `FirebaseConfig` and their setup assignments are gone. They were written and
    never read: `rtdbSignIn()` takes the endpoint from API_KEY / DATABASE_URL and the trust anchor
    from API_RO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
2026-10-10 fix(firmware): relay polarity is CONFIRMED ACTIVE-LOW — it was inverted in ten places
    The fitted relay modules are active-LOW: pulling a pin LOW energises the coil. The firmware assumed
    HIGH = energised, and did so in TEN separate places — so this was not a display bug.
    Both protection paths remove power by OPENING the relay, so an inverted level did the opposite of
    the safety intent:
    - the 4.5 A overcurrent cutoff skipped any port it read as "not energised" — i.e. every port that
    was actually live
    - the occupancy shutdown skipped ports it believed were already off
    - relay_status published to the app was inverted in both directions
    Fix: the level now lives in exactly one p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
2026-10-10 feat(firmware): the factory pairing key can be typed into the setup portal
    Baking the key into the image is what shipped keyless builds this session: the device joins Wi-Fi,
    looks perfectly healthy, and only then reports it has no key — a unit that can never pair, with the
    failure visible only on the serial console.
    Three changes:
    1. A `WiFiManagerParameter` on the captive portal asks for the key alongside the Wi-Fi credentials.
    Whatever is typed is saved to NVS (`pairing_key`) and pre-filled on subsequent visits, so
    re-opening the portal does not wipe it.
    2. `provisioningKey()` resolves NVS first, then the compiled-in VOLTSENSE_PAIRING_KEY. A build with
    no key is now recoverabl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
2026-10-14 feat: add sensor accuracy validation lab and 3D enclosure CAD files
2026-10-14 feat(ui): update Inactivity Limit card icon from AlertTriangle to Timer
2026-10-14 fix(ui): restyle alerts with VoltSense maroon theme and eliminate visual redundancies
2026-10-14 fix(mobile): redesign SensorValidationModal as native bottom sheet with stacked channel labels and proper z-index
2026-10-14 feat(test-lab): add dedicated Chapter 4 sensor validation lab and trial data recorder
2026-10-14 feat(test-lab): add full physical prototype validation and commissioning suite
2026-10-14 refactor(ui): remove redundant test lab buttons and banners from Dashboard and Settings
2026-10-14 refactor(test-lab): remove back button from header card
2026-10-15 feat(dashboard): show smart load connection state (in use, charging, empty socket, off)
2026-10-15 feat(cad): integrate final enclosure STL models and update 3D viewer
2026-10-15 feat(cad): update status LED diameter to 10 mm in OpenSCAD model
2026-10-15 feat(cad): redesign side ventilation grilles with 9 thinner high-airflow convective louvers
2026-10-15 fix(cad): resolve corner pillar collision with 3rd cable gland by shifting rear cutouts
2026-10-15 docs(cad): document rubber grommet pass-throughs for Powerflex Royal Cord SJT 16/3
2026-10-15 feat(cad): compile and update final STL models with 10mm LEDs, 9 thin vents, and cleared rear grommet holes
2026-10-15 fix(cad): add cache-busting to 3D viewer STL loader to always display latest models
2026-10-15 feat(cad): adapt user final CAD layout with 10mm LEDs, 9 thin vents, and cleared grommet holes
2026-10-23 feat(esp32): update pin mappings (GPIO 14/27), ACS712 divider scale, status LEDs, Wi-Fi recovery, and header fallback
2026-10-26 feat(web): add V, A & power computation to dashboard and per-outlet monitoring to analytics
2026-10-26 refactor(settings): remove mmwave radar toggle as dual-presence sensing is permanently fused in firmware
2026-10-26 feat(esp32): lock dual-presence mmWave fusion to permanent hardware sensing and publish individual telemetry
2026-10-26 fix(esp32): elevate current noise floor to 0.12A to suppress idle ghost readings
2026-10-26 feat(voltage): enable HAS_VOLTAGE_SENSE with Method A auto-calibration on boot and in TestLab
2026-10-26 refactor(dashboard): remove hero power computation and voltage/current badges
2026-10-26 fix(esp32): move PowerReading struct to VoltSenseTypes.h to resolve Arduino prototype compilation error
2026-10-26 fix(esp32): add robust ACS712 fallback when voltage sensor is absent and tune noise threshold to 0.05A
2026-10-26 fix(current-sense): eliminate ghost current readings on empty outlets via multi-layer noise floor gating and peak-to-peak filtering
2026-10-26 fix(firmware): implement True RMS for ACS712 and clamp readings to 0 when AC unplugged
2026-10-26 fix(database): add mmwave, discrete sensor validation rules, and port policy write permissions
2026-10-26 feat(cad): update enclosure to 208mm depth layout and recompiled final STLs
2026-10-26 feat(dashboard): add Power Factor pill and PF formula calculation to Port Management cards
2026-10-26 fix(firmware,ui): restore current fallback when voltage < 50V and lower noise floor for small adapters
2026-10-26 feat(settings): add Bench Test Mode toggle to switch between live ZMPT101B sensing and USB 220V fallback
2026-10-26 fix(build): track EmergencyAlertBanner, GodModePanel, soundAlert and wire layout banner
2026-10-26 fix(firmware): resolve string literal newline formatting in applyRemoteChange Serial.printf statements
2026-10-26 fix(power): correct real power dimensional formula, add AC polarity resilience, and unmask live current in dashboard
2026-10-26 revert(firmware): restore pure peak-to-peak ACS712 sensing and 220V nominal calculation from commit 2d2134b
2026-10-26 feat(calibration): add comprehensive current, voltage, and presence sensor calibration suite in firmware, God Mode, and Settings
2026-10-26 fix(settings): import missing SlidersHorizontal and calibration icons to fix crash
2026-10-26 fix(calibration): resolve setting override conflicts across firmware, God Mode, and Settings
2026-10-27 feat(telemetry): stabilize ACS712 True RMS current sensing and simplify P = V x I math
2026-10-27 feat(telemetry): standardize TestLab power display to Option B (Watts)
2026-10-27 style(dashboard): remove hover effects and smooth animations on master power buttons
2026-10-27 style(analytics): simplify outlet filter tabs to All, 1, 2, 3 and remove indicator dots
2026-10-27 fix(firmware): prevent relay toggle snapping back on, unblock turning off, and relax derating
2026-10-27 feat(settings): eliminate redundancies, wire bench_mode and dynamic timers to firmware
2026-10-27 style(settings): convert god mode toggle to compact icon-only button
2026-10-27 feat(setup): add Wi-Fi QR Code Auto-Join assistant, printable sticker, and fallback AP portal
2026-10-27 fix(settings-godmode): resolve relay bounce-back, add deferred auto-cal, fix RTDB permissions and telemetry sync
2026-10-27 feat(radar): implement Phase 1 mmWave radar UART gating, spatial filtering, and live telemetry
2026-10-27 revert(setup): remove QR code setup assistant and restore clean configuration flow
2026-10-27 style(analytics): use All, 1, 2, 3 labels for port filter tabs
2026-10-27 style(alerts): remove unused System filter tab from event log
2026-10-27 feat(god-mode): broadcast simulated emergency alert and siren to all connected devices
2026-10-27 fix(esp32): enable INPUT_PULLDOWN on PIR_PIN (GPIO 22) to prevent floating-pin EMI resets when unwired
2026-10-27 fix(dashboard): sync inactivity limit with enforced device telemetry and display live idle countdown
2026-10-27 fix(alerts): fire push notifications and cross-device broadcast on real hardware response window transition
2026-10-27 fix(dashboard): remove hover scale effect from keep power on button
2026-10-27 feat(settings): add configurable warning grace window (response_window_seconds) to Device Limits
2026-10-27 feat(alerts): make response window duration dynamic across God Mode, banner, and ESP32 firmware
2026-10-27 fix(dashboard): make port power unit dynamically match system load (W vs VA based on voltage_source)
2026-10-27 fix(analytics): sync power unit (W vs VA) with live voltage_source telemetry
2026-10-27 style(settings): hide test push notification button
2026-10-27 refactor(settings): extract Smart Vacancy Policy into separate container and redesign dropdown to match device selector
2026-10-27 fix(settings): separate Smart Vacancy Policy container and match dropdown design with device selector
2026-10-27 docs: add unified VoltSense RTDB database template JSON
2026-10-27 style(settings): remove green online indicator dot from paired devices list
2026-10-27 feat(device-presence): live heartbeat & online/offline status detection for selected ESP32
2026-10-27 style: remove device offline banner from dashboard
2026-10-27 style: remove redundant status dots from device dropdown menu
2026-10-27 fix(dashboard): remove raw seconds parenthesis from idle timer and add smooth 1s countdown interpolation
2026-10-27 fix(device-status): normalize UTC+8 NTP epoch offset so active telemetry reflects Powered On
2026-10-27 feat(vercel): enable dedicated /demo and /3d-demo routes and static CAD asset serving
2026-10-27 feat(demo): add public/cad interactive 3D digital twins, wiring diagrams, and CAD models
2026-10-27 fix(auth): support admin@voltsense.com to immediately bypass Google email rate limit
2026-10-27 fix(auth): update login email placeholder to voltsense@local.com
2026-10-30 docs: remove CAD, 3D enclosure, and hardware schematics; focus README on software and cloud architecture
